eeyzl5/autonomous-mapping-vehicle/README.md

# autonomous-mapping-vehicle
Final Year Project for BEng Electrical and Electronic Engineering

Video Demonstrations:
1. Static mapping: https://www.youtube.com/watch?v=KDEJdPsYzM8 
2. Dynamic mapping: https://www.youtube.com/watch?v=TBLsiB6ve2A 
3. Route planning with mapping: https://www.youtube.com/watch?v=nB8XvEBVgZQ
